65roadster/DC-Supply-170V-v1/README.md

# DC-Supply-170V-v1
 Lab supply for testing offline AC-DC converters
