65roadster/DC-Supply-170V-v1/BOM-DC-Supply-170V-v1.xlsx

170VDC Power Supply w/ Indicators
Main Circuit
Part | Qty | Description | Supplier | Link | Price ea | Extended
Fq | 2 | Fuse Holder | Digikey | https://www.digikey.com/products/en?keywords=schurter%200751.0110 | $0.14 | $0.28
D1 | 1 | GBU4A Bridge Rectifier | Digikey | https://www.digikey.com/products/en?x=0&y=0&lang=en&site=us&KeyWords=GBU4J-BP | $0.83 | $0.83
RT1 | 1 | Thermistor, 10 Ohm, 2A | Digikey | https://www.digikey.com/product-detail/en/epcos-tdk/B57153S0100M051/495-7096-1-ND/5418149 | $0.66 | $0.66
C1 | 1 | Capacitor, electrolytic, 330uF, 250V | Digikey | https://www.digikey.com/product-detail/en/nichicon/UVR2E331MRD6/493-1200-ND/588941 | $3.75 | $3.75
R1 | 1 | Resistor, 62 Ohm, 1210, 200V | Digikey | https://www.digikey.com/product-detail/en/stackpole-electronics-inc/RMCF1210JT62R0/RMCF1210JT62R0CT-ND/6053336 | $0.11 | $0.11
R2 | 1 | Resistor, 12 Ohm, 1210, 200V | Digikey | https://www.digikey.com/product-detail/en/stackpole-electronics-inc/RMCF1210JT12R0/RMCF1210JT12R0CT-ND/7906987 | $0.11 | $0.11
R3 | 1 | Resistor, 6.2 Ohm, 1210, 200V | Digikey | https://www.digikey.com/product-detail/en/stackpole-electronics-inc/RMCF1210JT6R20/RMCF1210JT6R20CT-ND/6053337 | $0.11 | $0.11
R4 | 1 | Resistor, 10k, 0805 | Stock |  | $0.00 | $0.00
R5 | 1 | Resistor, 10k, 0805 | Stock |  | $0.00 | $0.00
Q1 | 1 | TIP50G NPN, 400V, TO-220AB | Digikey | https://www.digikey.com/product-detail/en/on-semiconductor/TIP50G/TIP50GOS-ND/920355 | $0.68 | $0.68
Q2 | 1 | BSP16T1G, NPN, 100mA, 300V | Digikey | https://www.digikey.com/product-detail/en/on-semiconductor/BSP16T1G/BSP16T1GOSCT-ND/3462250 | $0.37 | $0.37
PCB | 1 | PCB | PCBWay |  |  | $1.50
 |  |  |  |  |  | $8.40
Bleeder
Q3, Q4 | 2 | AO3162, N-MOS, 34mA, 400V, SOT23 | Digikey | https://www.digikey.com/product-detail/en/alpha-omega-semiconductor-inc/AO3162/785-1458-1-ND/3603466 | $0.35 | $0.70
C2 | 1 | 0.1uF Ceramic cap, 250V | Digikey | https://www.digikey.com/product-detail/en/w-rth-elektronik/885342208004/732-12118-1-ND/9346138 | $0.17 | $0.17
R6, R7, R8 | 3 | 1M Ohm, 300V, 0805 | Digikey | https://www.digikey.com/product-detail/en/rohm-semiconductor/KTR10EZPJ105/RHM1-0MBCT-ND/1763549 | $0.14 | $0.42
D3, D4 | 2 | Diode, zener, 24V, 300mW, SOD-323 | Digikey | https://www.digikey.com/product-detail/en/on-semiconductor/MM3Z24VT1G/MM3Z24VT1GOSCT-ND/2623465 | $0.14 | $0.28
D7 | 1 | Diode, 1N4004 | Stock |  | $0.00 | $0.00
 |  |  |  |  |  | $0.87
Indicators
R11 | 1 | Resistor, 100 Ohm, 0805 | Stock |  | $0.00 | $0.00
R13 | 1 | 1M Ohm, 300V, 0805 | Digikey | https://www.digikey.com/product-detail/en/rohm-semiconductor/KTR10EZPJ105/RHM1-0MBCT-ND/1763549 | $0.14 | $0.14
C3 | 1 | 0.1uF Ceramic cap, 250V | Digikey | https://www.digikey.com/product-detail/en/w-rth-elektronik/885342208004/732-12118-1-ND/9346138 | $0.17 | $0.17
D5 | 1 | LED, 0805 | Stock |  | $0.00 | $0.00
D6 | 1 | Diode, 1N4004 | Stock |  | $0.00 | $0.00
R10, R12 | 1 | Resistor, 2.5k, 0805 | Stock |  | $0.00 | $0.00
R14 | 1 | Resistor, 2k, 0805 | Stock |  | $0.00 | $0.00
R15 | 1 | Resistor, 1.16k, 0805 | Stock |  | $0.00 | $0.00
R16 | 1 | Resistor, 10k, 0805 | Stock |  | $0.00 | $0.00
D5 | 1 | LED, 0805 | Stock |  | $0.00 | $0.00
U1 | 1 | LR8N8-G | Digikey | https://www.digikey.com/products/en/integrated-circuits-ics/pmic-voltage-regulators-linear/699?k=LR8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 | $0.62 | $0.62
 |  |  |  |  |  | $0.93
 |  |  |  |  | Total | $10.20
