65roadster/DC-Supply-170V-v1/DC-Supply-170V-v1.kicad_pcb

## KiCad design DC-Supply-170V-v1.kicad_pcb (2020-06-25)

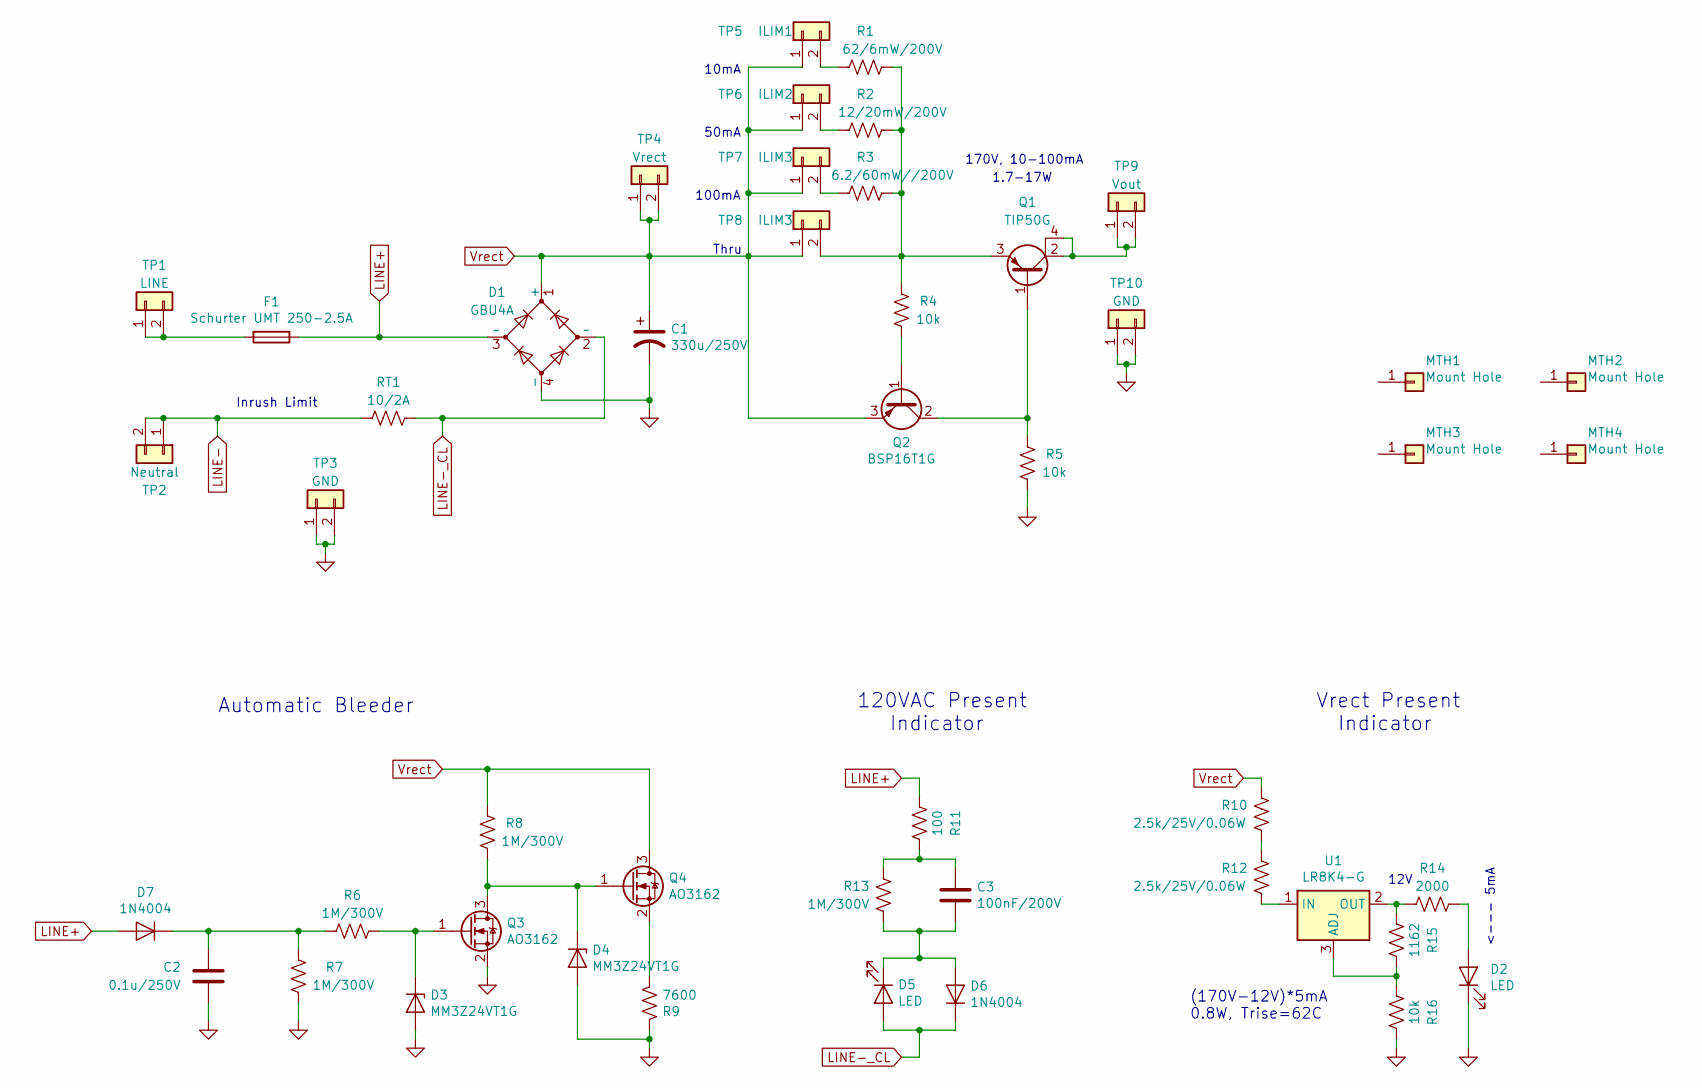
[picture p1: schematic DC-Supply-170V-v1.sch]

Parts:
C1: 330u/250V; Nichicon-UVR2E331MRD6-Cap-330uF-250V
C2: 0.1u/250V; C_1206_HandSoldering
C3: 100nF/200V; C_1206_HandSoldering
D1: GBU4A; GBU4A-Bridge-Rectifier
D2: LED; LED_0805_2012Metric
D3, D4: MM3Z24VT1G; D_SOD-323_HandSoldering
D5: LED; LED_0805_2012Metric_Pad1.15x1.40mm_HandSolder
D6, D7: 1N4004; D_SMA_Handsoldering
F1: Schurter UMT 250-2.5A; Schurter-0751.0110-Fuse-Clip-5mm_20mm
MTH1, MTH2, MTH3, MTH4: Mount Hole; Mount-Hole-#6
Q1: TIP50G; TO-220-3_Horizontal_Tab4
Q2: BSP16T1G; SOT-223-3_TabPin2
Q3, Q4: AO3162; SOT-23-3_HandSoldering
R1: 62/6mW/200V; R_1210_HandSoldering
R2: 12/20mW/200V; R_1210_HandSoldering
R3: 6.2/60mW//200V; R_1210_HandSoldering
R4, R5, R16: 10k; R_0805_HandSoldering
R6, R7, R8, R13: 1M/300V; R_0805_HandSoldering
R9: 7600; R_2512_HandSoldering
R10, R12: 2.5k/25V/0.06W; R_0805_HandSoldering
R11: 100; R_0805_HandSoldering
R14: 2000; R_0805_HandSoldering
R15: 1162; R_0805_HandSoldering
RT1: 10/2A; Thermistor-TDK-B5713S0xxxM0xx
TP1: LINE; Green_Terminal_Block_x02_150mil
TP2: Neutral; Green_Terminal_Block_x02_150mil
TP3: GND; PinHeader_1x02_P2.54mm_Vertical
TP4: Vrect; PinHeader_1x02_P2.54mm_Vertical
TP5: ILIM1; PinHeader_1x02_P2.54mm_Vertical
TP6: ILIM2; PinHeader_1x02_P2.54mm_Vertical
TP7, TP8: ILIM3; PinHeader_1x02_P2.54mm_Vertical
TP9: Vout; Green_Terminal_Block_x02_150mil
TP10: GND; Green_Terminal_Block_x02_150mil
U1: LR8K4-G; SOT-223-3_TabPin2

Connections:
GND: C1.2, C2.1, D1.4 (-), D2.1 (K), D3.2 (A), D4.2 (A), Q3.2 (S), R5.1, R7.2, R9.2, R16.2, TP3.1, TP3.2, TP10.1, TP10.2
LINE+: D1.3 (~~), D7.2 (A), F1.1, R11.2
LINE-: RT1.2, TP2.1, TP2.2
LINE-_CL: D1.2 (~~), D5.2 (A), D6.1 (K), RT1.1
unnamed: C2.2, D7.1 (K), R6.2, R7.1
unnamed: C3.1, R11.1, R13.1
unnamed: C3.2, D5.1 (K), D6.2 (A), R13.2
unnamed: D2.2 (A), R14.2
unnamed: D3.1 (K), Q3.1 (G), R6.1
unnamed: D4.1 (K), Q3.3 (D), Q4.1 (G), R8.1
unnamed: F1.2, TP1.1, TP1.2
unnamed: Q1.1 (B), Q2.2 (C), R5.2
unnamed: Q1.2 (C), Q1.4 (C), TP9.1, TP9.2
unnamed: Q1.3 (E), R1.2, R2.2, R3.2, R4.2, TP8.2
unnamed: Q2.1 (B), R4.1
unnamed: Q4.2 (S), R9.1
unnamed: R1.1, TP5.2
unnamed: R2.1, TP6.2
unnamed: R3.1, TP7.2
unnamed: R10.2, R12.1
unnamed: R12.2, U1.1 (IN)
unnamed: R14.1, R15.1, U1.2 (OUT)
unnamed: R15.2, R16.1, U1.3 (ADJ)
Vrect: C1.1, D1.1 (+), Q2.3 (E), Q4.3 (D), R8.2, R10.1, TP4.1, TP4.2, TP5.1, TP6.1, TP7.1, TP8.1

Notes on the sheet:
Inrush Limit
1.7-17W
170V, 10-100mA
50mA
Thru
10mA
Automatic Bleeder
100mA
120VAC Present Indicator
Vrect Present Indicator
(170V-12V)*5mA 0.8W, Trise=62C
12V
<--- 5mA

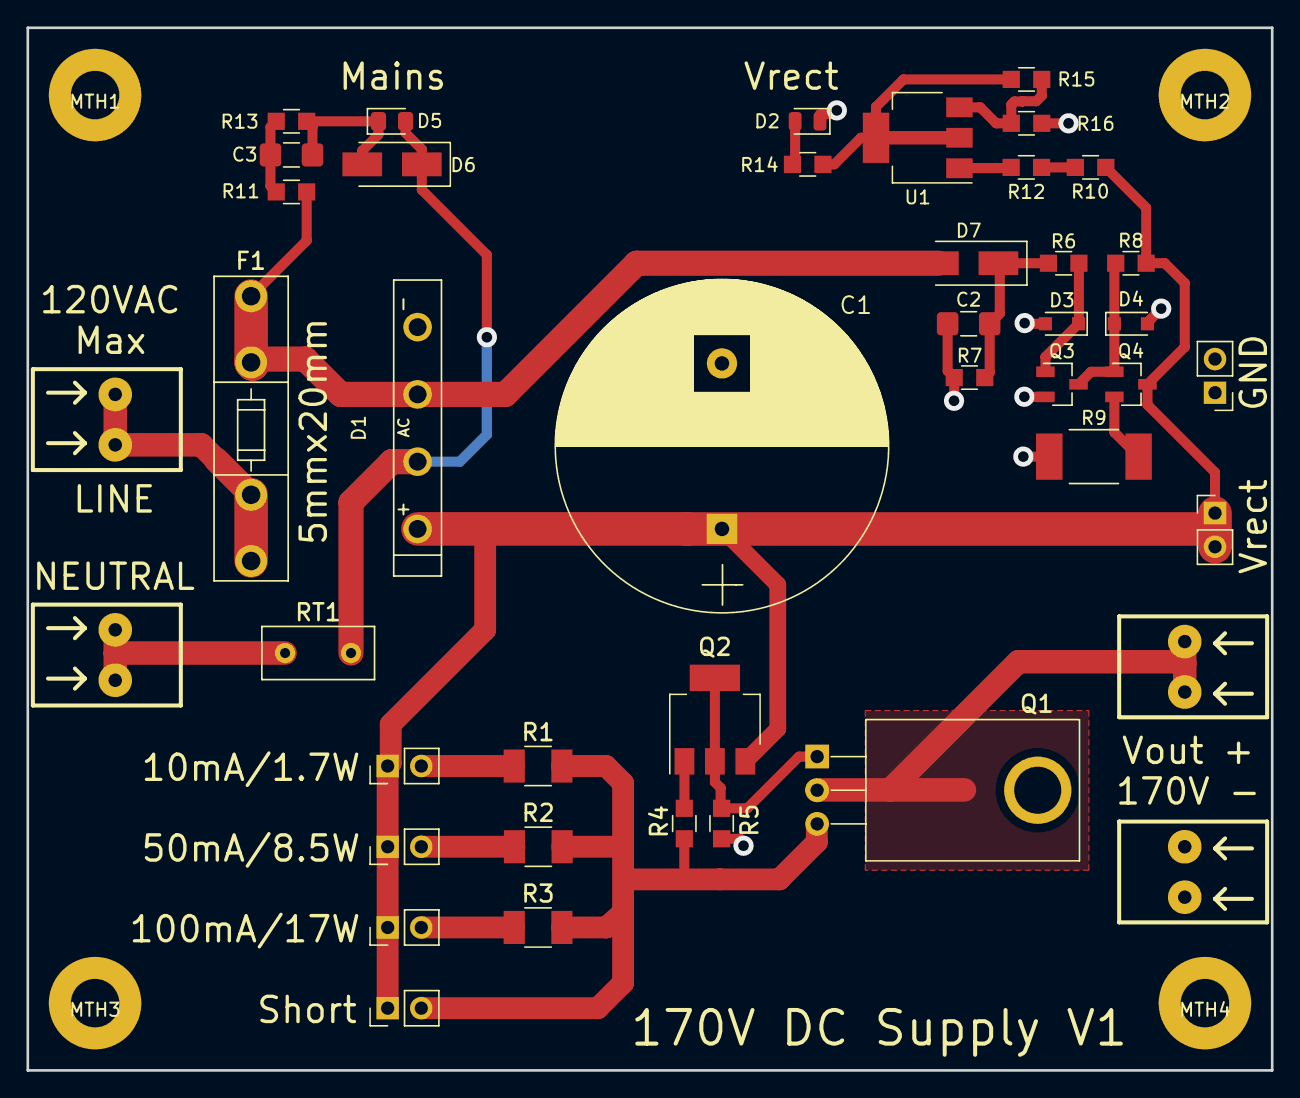
[picture p2: board DC-Supply-170V-v1.kicad_pcb from above]

Board: 2 copper layers, 94.0 x 78.7 mm, 47 parts (0 on the bottom side), 24 nets.
