65roadster/DC-Supply-170V-v1/(commit log)

2020-06-16 Layout tweaks before PCB order
    [DC-Supply-170V-v1-B_Cu.gbr, DC-Supply-170V-v1-B_Mask.gbr, DC-Supply-170V-v1-Edge_Cuts.gbr, DC-Supply-170V-v1-F_Cu.gbr, DC-Supply-170V-v1-F_Mask.gbr, DC-Supply-170V-v1-F_SilkS.gbr, DC-Supply-170V-v1-NPTH.drl, DC-Supply-170V-v1-PTH.drl]
2020-06-25 finalized before PCB order
    [DC-Supply-170V-v1-B_Cu.gbr, DC-Supply-170V-v1-B_Mask.gbr, DC-Supply-170V-v1-Edge_Cuts.gbr, DC-Supply-170V-v1-F_Cu.gbr, DC-Supply-170V-v1-F_Mask.gbr, DC-Supply-170V-v1-F_SilkS.gbr, DC-Supply-170V-v1-NPTH.drl, DC-Supply-170V-v1-PTH.drl]
